ealfaro29/livinginacat-world/public/assets/social-cat-world-dark-v2.png

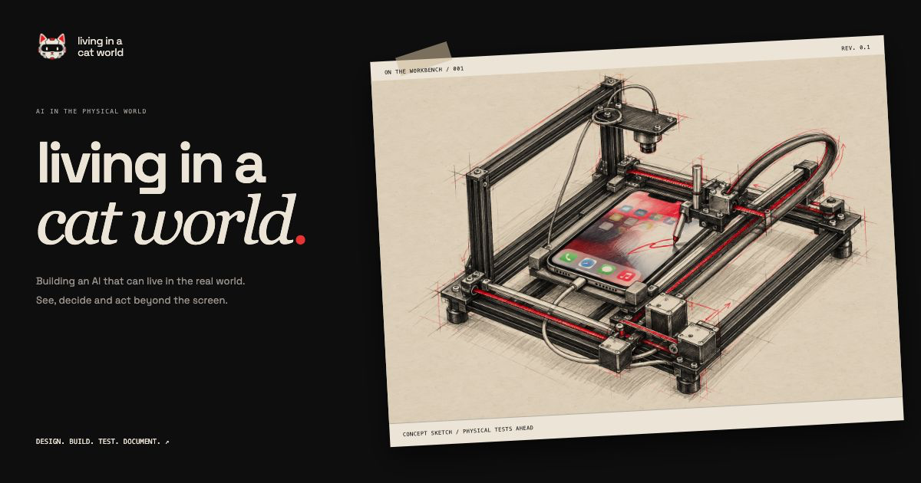
public/assets/social-cat-world-dark-v2.png
