ealfaro29/livinginacat-world/public/assets/prototype-rough-v1.png

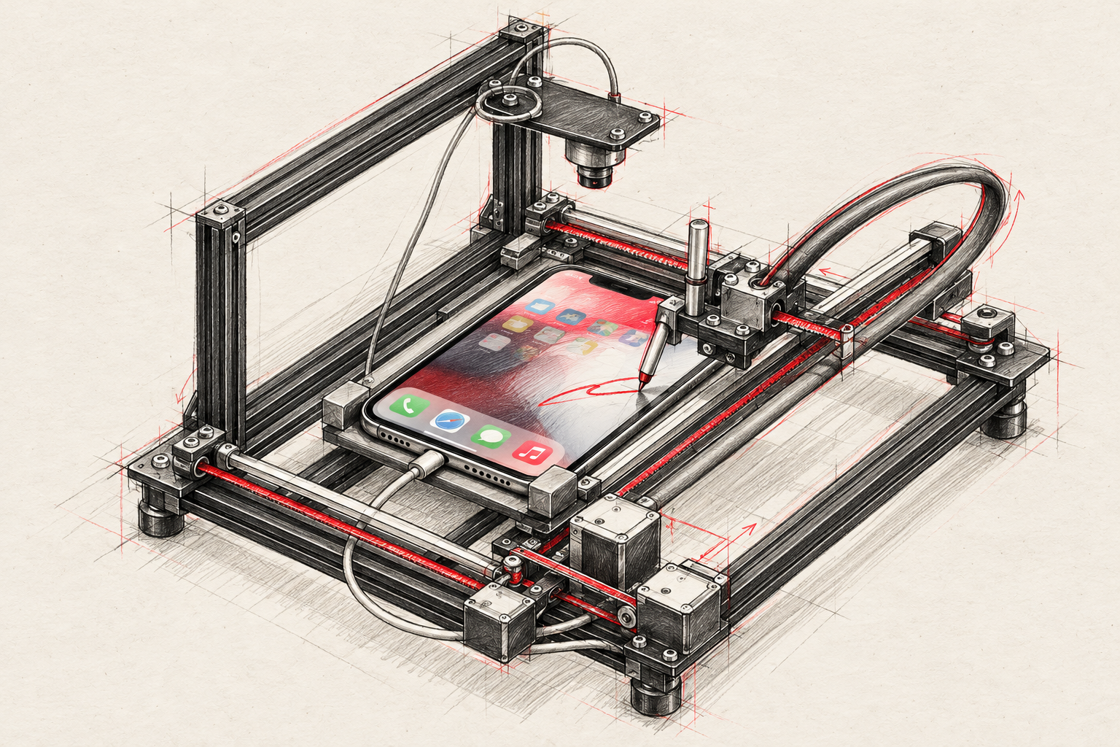
public/assets/prototype-rough-v1.png
