ealfaro29/livinginacat-world/hardware/ft412/PUBLIC-RELEASE.md

# Public release scope

16 final STL designs and their 16 STEP files; 22 installed printed parts plus three fit coupons. The v0.1 archive remains the original digital-review snapshot, with its checksum unchanged. Use `qa/print-manifest.json` for quantities and `README.md` for planned assembly.

Current build observations, reported November 13, 2026: the first test batch is complete and the owner reports M3 and M5 checks passed in PLA Silk with a 0.4 mm nozzle. M4, coupler fit, PETG and full assembly acceptance remain unvalidated. Results for each hole, pocket and head seat were not individually itemized. These observations do not certify the archive or change its geometry. See the [dated fit-check report](/documentation/fit-checks/).

This release excludes commercial `vendor/`, `reference_step/`, `original_stl/`, `upstream/`, reference assemblies and regeneration scripts that depend on them. Intermediate CAD records may describe the larger private working environment; they are not additional printable parts or a self-contained regeneration pipeline.

Public instructions are in English. Machine-generated CAD review artifacts retain their original identifiers and some original-language annotations. They are evidence snapshots, not proof of physical performance.

The provisional development temperature stop is unified to 45 °C on externally measured body/support surfaces, alongside the guide’s timing limits. This unvalidated rule does not measure internal coil temperature.
