ealfaro29/livinginacat-world/docs/DATA.md

# Ledger maintenance

Public source: `data/ledger.json`. USD amounts are integer cents. `null` means unknown. Dates use YYYY-MM-DD. `updatedAt` retains the UTC review date; `reviewedAt` is the completed source-review timestamp and `reviewTimeZone` controls its display in Costa Rica. Neither is a delivery event. A shipment's `speedyReviewedAt` records the latest full-account check without replacing its carrier or recipient event date. Confirmed carrier deliveries display `carrierDeliveredDate`, or explicitly leave the date unknown, rather than reusing an earlier estimate.

`data/build-progress.json` contains selected, anonymized current build observations, separate from the immutable v0.1 CAD archive metadata. The November 13 owner report confirms M3 and M5 checks in PLA Silk, without itemized hole, pocket or seat measurements. Keep M4, coupler fit, PETG and full assembly acceptance unconfirmed. These coupon observations do not validate the complete robot or change the archive's checksum.

## Overlapping records: do not add together

- `items`: original equipment list and quotes. Quantity means purchase units, not always individual parts. Quoted total = quantity × quoted unit price.
- An unquoted local purchase keeps both quote amounts `null`; downloads leave numeric price cells blank. The known equipment estimate excludes it and states how many lines remain unquoted. Stable item IDs survive a replacement or vendor change; `previousProcurement` retains the earlier quote. A cancelled vendor's quote remains historical even after the current items move to another vendor.
- `equipmentAllowances`: owner-requested planning amounts, kept separate from item quotes, orders and verified payments. The equipment estimate is item quotes plus these allowances.
- `orders`: vendor-level quote, documentary order total and verified payment where evidence exists. `invoiceTotalCents` is the order amount; `shippingInvoicedCents`, `taxInvoicedCents` and `tariffInvoicedCents` describe its charges. An order confirmation alone does not establish payment. The owner may confirm shipped purchases are paid; record this as owner confirmation rather than bank verification. `actualPaidCents` and the `*PaidCents` fields remain unknown when a reliable amount is unavailable. For a partially shipped order, do not assume the whole order is paid or invent an allocation. For a vendor aggregate, `paymentPartial` marks a subtotal across confirmed paid orders. Paid tax and shipping are breakdowns of the paid total, not additional amounts to add again.
- An `awaiting_invoice` order acknowledges a request awaiting the vendor's final invoice. `invoiceTotalFinal: false` and `shippingChargeFinal: false` distinguish provisional amounts from final charges; neither establishes payment or dispatch.
- `amazonOrders`: anonymized extracts of confirmed orders. They include equipment and extras. Documentary order totals are distinct from reconciled bank payments. When complete carrier fulfillment is verified, the owner's existing confirmation that shipped purchases are paid can cover the documented total; retain the owner-confirmation source and the bank-settlement caveat.
- `otherExpenses`: domain and grouped **Taxes, tariffs, shipping and others** totals per vendor. `includedInVendorOrderTotals: true` prevents double counting. The grouped total includes documented vendor shipping, taxes, tariffs and other included costs. Keep the underlying actual tax and tariff evidence in the private records; do not describe other purchases as tax. Speedy charges in CRC are separate. A standalone owner-confirmed project expense uses the same grouped label with `includedInVendorOrderTotals: false`; its verified payment is added once to project totals. It creates no equipment, vendor order or shipment record when the owner confirms there is no shipping.
- `forwardingCharges`: one dated combined Speedy amount in CRC for **all current packages**, with no filter by project membership. Review the entire current account and all current consolidations, including packages not yet quoted. Review active `Recibido`, `En Costa Rica` and `Enviado` queues without filtering charges by a known consolidation, project match or earlier review. `Enviado` alone does not prove payment. Exclude records confirmed `Pagado` or `Entregado` unless newer evidence establishes an outstanding charge. When a new consolidated parcel coexists with its original records and their billing replacement relationship is not verified, use `hasUnresolvedConsolidationCharges` in `aggregateForwardingCharges`. It returns `amountCRC: null` and `quoteStatus: reconciliation_pending`; publish the pending status without a numeric total. Preserve the last verified amount privately and in dated history. Do not infer charge replacement from similar weights, dates or counters. Use `aggregateForwardingCharges` to sum every quoted current package once; unquoted packages keep `quoteStatus: awaiting_remaining_quotes` and must never be treated as free or omitted from the review. Publish only the combined amount, currency, observation date, coverage and payment/finality caveats. Package identities, counts, weights, individual charges, matching evidence and the complete observation history stay outside user-facing views. The owner explicitly requires this full scope. Do not add restricted package details to project records or location counts. Do not mark the amount paid or combine it with USD totals without evidence, and do not assume it is the final consolidated balance.
- `shipments`: real project shipment or preparation record. `trackingAssigned` records that the private project shipment has a verified assigned number; the number itself stays private. It does not establish carrier acceptance, Speedy receipt or recipient delivery. `status` describes the carrier; `speedyStatus` describes separately confirmed forwarder progress. `speedyLocation` is `miami` or `costa_rica` only when Speedy's exact tracking entry supports it; otherwise it is `null`. `speedyCheckedAt` records the review date, and `speedyConfirmedAt` records the latest affirmative observation. Planned dispatch is distinct from estimated arrival. Complete `deliveredAt` only with recipient-delivery evidence. A suffix-only tracking match is insufficient for a project location assertion.
- `funding`: preserve unknown amounts until reconciled. Do not publish individual supporters or contributions without authorization.

Carrier-verified tracking aliases may establish project identity when Speedy scans a longer carrier barcode. Keep both exact references and the independent carrier evidence privately. Matching a suffix alone is insufficient. The two original Amazon FedEx shipments are confirmed in Costa Rica after their vendor tracking and Speedy barcode independently resolve to identical FedEx shipment facts; recipient delivery remains unconfirmed.

The November 9 full-account identity audit also verifies the longer USPS barcodes for BoltDepot, PhotonLight, West3D and Walmart spacers: both complete identifiers independently resolve to identical full USPS tracking histories, and Speedy shows each as `Recibido`. Record these shipments as `received` in Miami, ready for forwarding to Costa Rica. `Recibido` is affirmative Speedy receipt; it must not remain described as unconfirmed after this identity verification. Keep each Walmart fulfillment group tied to its own item and shipment so a spacer receipt does not advance the foam or wrap. Preserve these verified aliases for subsequent reviews and the owner's item marks separately.

Cancelled orders retain their original documentary amounts and grouped charges, with unknown payments and refunds unchanged. Exclude them from active order totals, active grouped-cost summaries and the tracking queue. Cancellation does not itself establish a refund. Confirmed replacements get their own order and preparation record; a planned local purchase gets no imported shipment or Speedy prealert.

Keep cancelled shipment records in `shipments` as history. `activeShipments` excludes them, and shipments whose parent order is cancelled, from public tracking groups, coverage and location counts. A vendor-reported refund may have `refundCents` while `refundStatus: vendor_reported` and `refundBankSettlementConfirmed: false` preserve the distinction from a verified bank credit.

Owner-confirmed payment and recipient delivery exclude historical forwarding charges even when Speedy retains an old `Enviado` label. Pass explicitly settled references through `aggregateForwardingCharges`'s `settledTrackings` option; preserve those references and the confirmation privately. Do not exclude an unsettled charge merely because it is old or marked `Enviado`. Only new evidence of an outstanding balance can reopen a confirmed settlement.

## Initial evidence

Carrier returns use `shipments.status: returned` and remain separate from recipient delivery, refunds and replacements. Keep the original purchase and payment evidence. A return still counts as a reported shipment; it appears in the carrier-return group instead of the queue awaiting Speedy confirmation. The private carrier record uses `on_hold` with the verified return evidence.

Bambu Lab support confirmed the original return and offered a replacement at no additional vendor charge. Preserve the original purchase, payment, returned shipment and all documents. USPS confirmed acceptance on November 12 and out for delivery on November 13, then actual carrier delivery to the Miami destination on November 13 at 4:50 PM, in or at the mailbox; the source timezone is unspecified. This carrier event does not establish Speedy receipt, Costa Rica arrival or recipient delivery. The unique original prealert remains complete and is now verified in a newly created forwarding group without recreation or early shipment. That group has no receipts linked. Its operational identifiers, membership and documents remain protected. No refund or bank settlement is independently confirmed.

FramingTech: payment email and PDF confirmation. GoDaddy: email receipt. Amazon: authenticated order details, order invoices and tracking pages. DigiKey and BoltDepot: vendor order confirmation emails, without shipment or settled-payment evidence. Walmart: confirmation email and authenticated order details; fulfillment groups at Placed status and estimated arrival windows are not dispatched packages. Private originals stay outside the repository. AMZ codes are public references independent of actual order numbers.

Mouser: the November 5 owner confirmation and original order-summary PDF total $82.07 and remain historical `order_confirmation` evidence. On November 7 the authenticated order page and shipping email confirm all ten references shipped with FedEx tracking. The authentic final invoice verifies one unit of each reference, a $87.22 total and an explicit paid-in-full vendor statement. Record that vendor payment evidence separately from unverified bank settlement; retain the previous confirmation amount. Invoice goods values support the prealert article entries; do not turn vendor charges into additional goods. Only the combined vendor charges are published under Taxes, tariffs, shipping and others. FedEx confirms carrier delivery in Miami on November 9. Its authentic final invoice, Speedy prealert and consolidation remain confirmed. Record the November 9 carrier delivery separately. On November 10 Speedy confirms received in Miami after both full FedEx identifiers independently resolve to identical complete travel history and shipment facts. Keep the verified barcode alias privately. Costa Rica arrival and recipient delivery remain unconfirmed; preserve the original invoice, prealert, consolidation assignment and purchase amount. The planned local wire purchase remains unconfirmed.

VXB: the owner sent the cancellation request on November 5. The vendor confirmed cancellation on November 6 and reports a full $65.22 refund; receipt by the bank is not independently verified. Retain the original order amounts, USPS label, Speedy prealert and consolidation as history, excluded from active order totals and shipment counts. The earlier expected restock date is superseded by cancellation.

Amazon controller replacement: authenticated order details and the original printable confirmation verify the November 7 purchase. AMZ-07 remains a separate order, and the stable controller item retains the cancelled VXB quote in `previousProcurement`. The November 9 complete fulfillment review identifies the controller's own Amazon tracking, Shipped at step 2 of 4, with estimated Miami arrival November 10. Its earlier parcel association is corrected using the actual item in each fulfillment group. The current authenticated purchase PDF and matching merchant transaction marked Completed support a genuine purchase receipt; this does not verify bank settlement or a final tax invoice. The original confirmation is preserved. Speedy now confirms the controller prealert and its consolidation together with the Mouser shipment. Carrier delivery and Speedy receipt remain unconfirmed. Keep the shared receipt in protected operational evidence outside the ordinary owner room, retain only the combined public order total, and include charges once under Taxes, tariffs, shipping and others. `costVisibility: vendor_grouped` keeps private components distinct from unknown or zero amounts. Track other operational parcels separately; never assign an item to the first tracking link merely because it belongs to the same order. Submit one prealert per exact tracking with only that parcel's authentic goods quantities and values. On November 10 the exact controller tracking page confirms Delivered today at the verified Miami destination. Record carrier_delivered and the November 10 carrier event separately from unconfirmed Speedy receipt and recipient delivery; keep the original purchase and payment evidence unchanged.

Walmart: the authenticated exact-order page showed every fulfillment group delivered on the November 6 review. The arrival email and matching wrap group confirm its carrier delivery on November 6, tied to the existing tracking through the earlier shipment evidence. Complete order fulfillment also confirms the foam's carrier delivery; do not assign an individual delivery date that has not been matched. Payment amounts remain unchanged. Carrier delivery does not establish Speedy receipt or delivery to the recipient. On November 10 Speedy confirms the cable-management shipment received in Miami. Both complete USPS identifiers independently show identical full histories, including carrier delivery to an agent on November 6 at 10:08 AM. Preserve the verified alias privately and keep the foam group separate and unresolved. Costa Rica arrival and recipient delivery for the cable-management shipment remain unconfirmed.

## Updating

In the November 14 UTC review (November 13 in Costa Rica), Speedy confirms the exact Walmart cable-management shipment in Costa Rica through its previously independently verified full USPS alias. The same exact scanned reference is now listed among receipts in its original consolidation. Actual arrival date and recipient delivery remain unconfirmed. Preserve the original carrier delivery, purchase, prealert and assignment. USPS separately confirms carrier delivery of the replacement to Miami on November 13; do not mark Miami in the item tracker until Speedy confirms receipt.

On November 13 Speedy confirms the existing BoltDepot, Walmart spacers and PhotonLight shipments in Costa Rica. Each current entry matches its previously verified complete carrier alias, and the same three packages are now explicitly linked among the received packages of their existing consolidation. Preserve each original purchase, carrier delivery, PDF, prealert and assignment. This advances only the three exact project shipments; recipient delivery and the actual arrival dates remain unconfirmed. The replacement's separate USPS out-for-delivery status does not establish Speedy receipt. Forwarding-charge reconciliation remains pending without a numeric aggregate.

Owner-reported recipient delivery plans are dated forecasts. Record the date of the owner report separately from the expected recipient delivery date. Preserve item stages and leave recipient receipt unconfirmed until the owner or an exact forwarding record confirms it; a processed consolidation or planned date creates no tracking alias and resolves no billing relationship.

On November 12 the owner confirms receipt of existing project shipments, corroborated by their exact Speedy entries now marked delivered. Advance only the precisely matched project shipments and item groups, preserving split-order associations and owner checkbox edits. The earlier recipient delivery forecast is superseded. Keep the actual delivery date unknown and distinguish receipt of a shipment from verification of every piece and quantity inside it. The owner also confirms the physical count and relative size groups of the FramingTech profiles; their exact cut lengths remain unmeasured. Forwarding billing reconciliation remains pending, without a current numeric total or an inferred container alias.

On November 11 the owner identified the previously unresolved Walmart foam package and confirmed physical receipt. The protected original tracking and alternate forwarder code are linked by explicit owner confirmation, separately from carrier-verified aliases. Record the project foam as delivered to the recipient, preserve the existing carrier delivery, purchase, prealert and consolidation, and keep the exact recipient delivery date unknown. The former unresolved tracker row is retained as protected history and linked to the existing foam item rather than displayed twice. This does not advance the separate cable-management or spacer shipments.

On November 11 three project prealerts for shipments already received in Miami were reassigned to the current active forwarding consolidation with owner authorization. Their authentic documents, quantities and declared values were preserved and the three destination entries were verified without duplicates. Keep exact consolidation membership and administrative form dates in protected evidence and the authenticated tracker. Recreating a prealert does not establish an arrival, advance a shipping phase or change the purchase total or observed forwarding charges.

On November 11 Speedy confirms receipt in Miami for the exact project controller tracking. Preserve Amazon's separate November 10 carrier delivery, the authentic purchase receipt, prealert and current consolidation. The observation date is not a verified Speedy receipt event date. Costa Rica arrival, recipient delivery, bank settlement and final tax invoice remain unconfirmed.

1. Read current evidence and retain its original reference privately.
2. Update only verified fields, preserving uncertainty.
3. Add a `changes` entry with date, title and detail. Record verified cancellation, refund or return amounts explicitly; retain history rather than silently deleting records.
4. Run arithmetic and relationship tests. Expand checks when the data model changes.
5. Regenerate and compare CSV, JSON, Markdown and HTML against the same source.
6. Commit, publish and verify live. Journal posts remain dated snapshots; tables show the latest record.

Maintaining this ledger does not authorize purchases, payment-method changes, outgoing email or recurring monitoring.

## Public and private boundary

Never mention or display personal purchase details in messages, the public site, downloads or the interactive owner room. Preserve operational evidence outside those views; shared-order originals are not downloadable through the owner room. Public records retain their exact grouped amounts under Taxes, tariffs, shipping and others without product names, product identifiers, quantities, photos, invoices or descriptions that reveal those purchases. Preserve actual tax and tariff amounts; do not relabel other purchases as tax. Shipment updates for this category use a generic title. Never copy private admin data or original invoice contents into public source, posts, downloads, screenshots or commit messages. `npm run check` blocks restricted identities before publication.

TechStorex: the owner confirms an additional project expense of $537.00, temporarily classified under Taxes, tariffs, shipping and others. Original payment evidence is retained privately. It has no shipping, equipment allocation, tracking or Speedy prealert. Bank settlement is not independently verified. The vendor total is recorded once as a standalone expense.
