ealfaro29/livinginacat-world/public/assets/brand/robot-cat-180.png

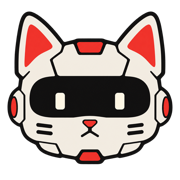
public/assets/brand/robot-cat-180.png
