ealfaro29/livinginacat-world/hardware/ft412/qa/parts-preview.png

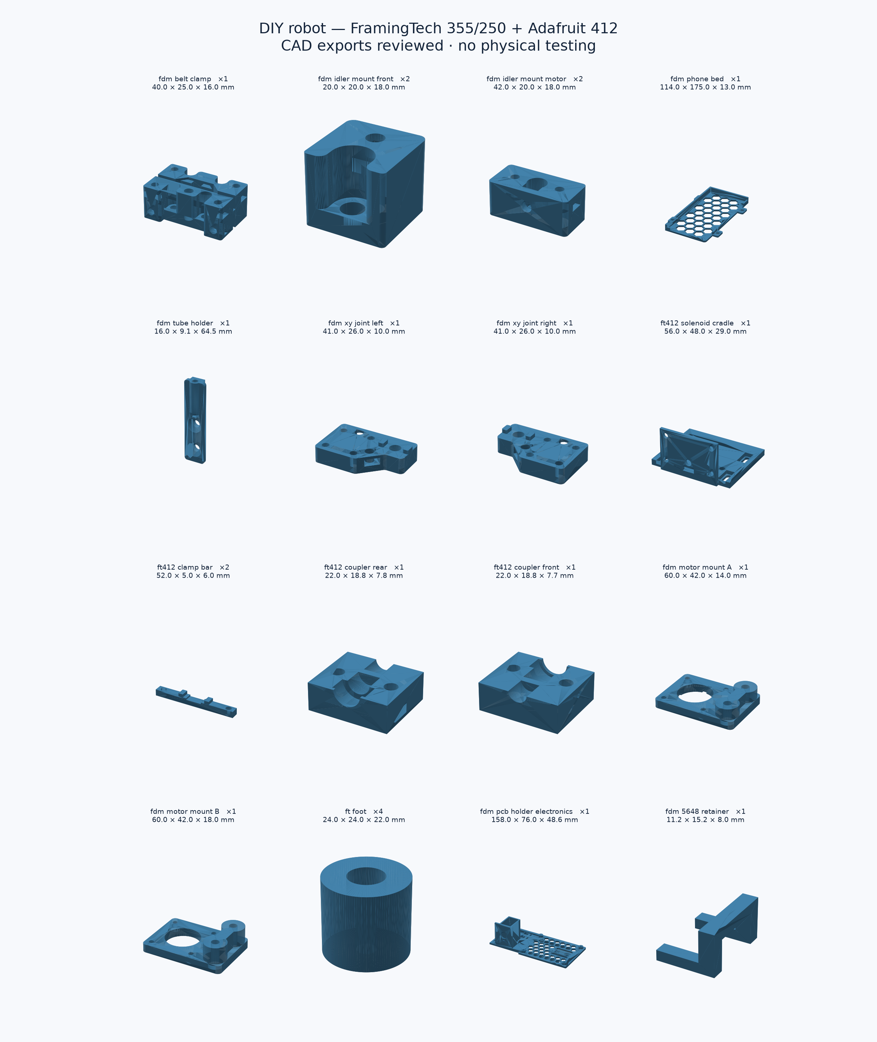
hardware/ft412/qa/parts-preview.png
