ealfaro29/livinginacat-world/public/assets/shopping-list-1080x1440.png

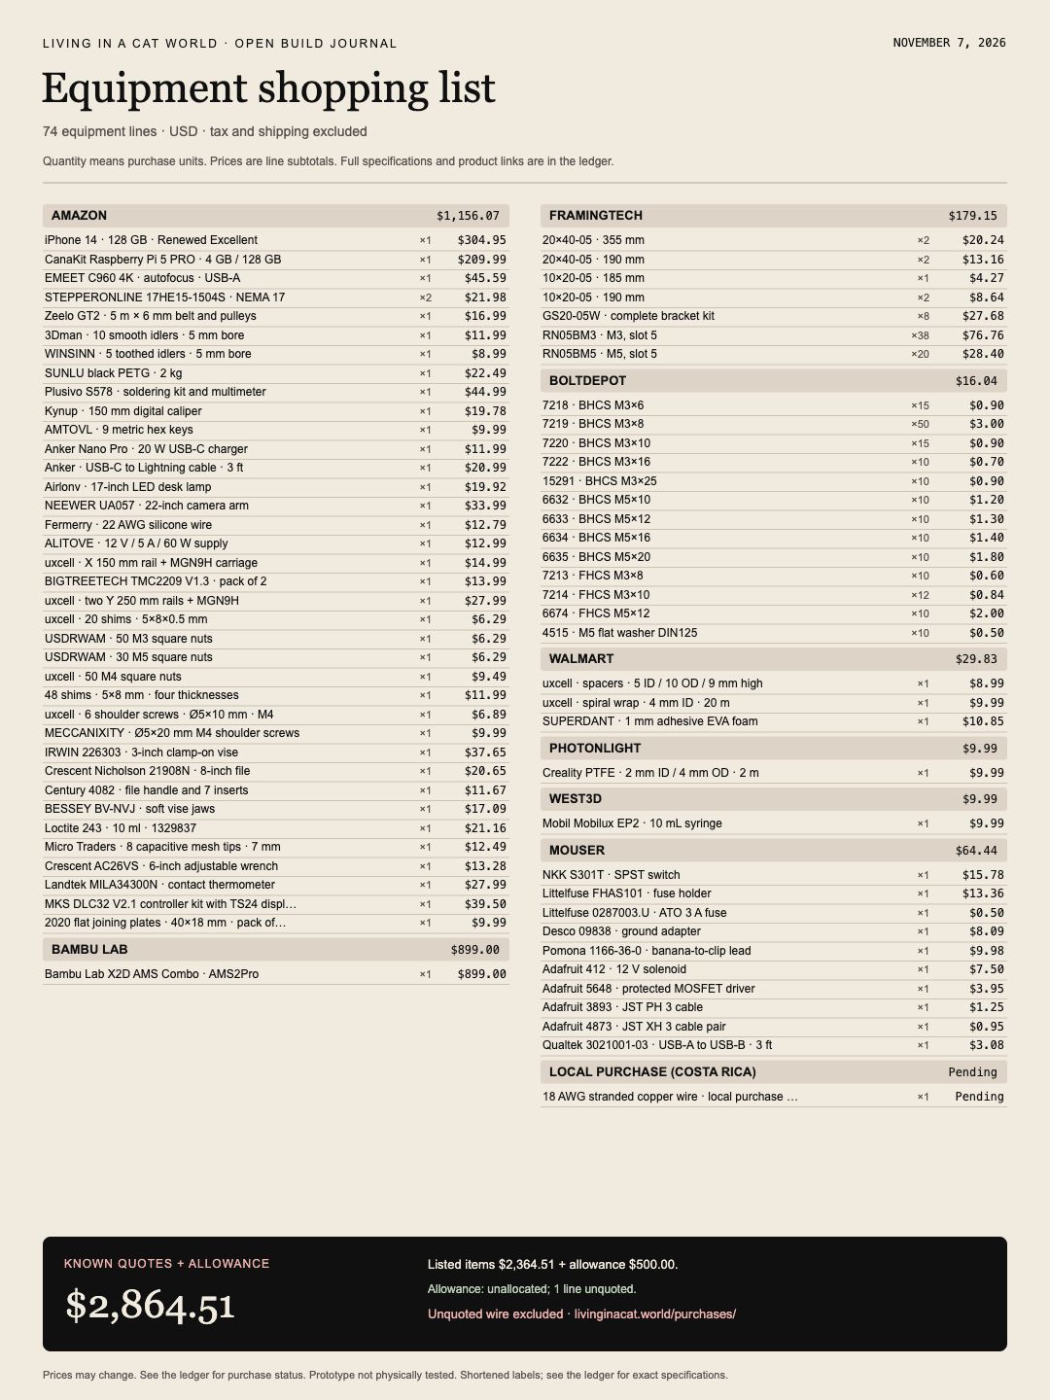
public/assets/shopping-list-1080x1440.png
