ealfaro29/livinginacat-world/hardware/ft412/coupons/fdm_countersink_coupon.stl

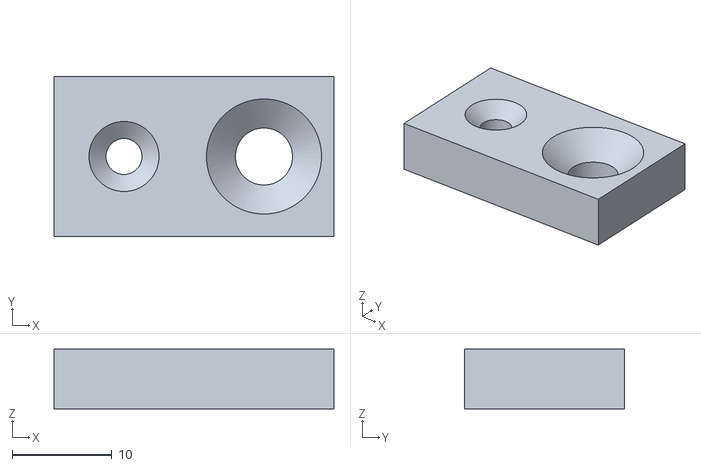
[picture p6: CAD file, 2026-10-26]
hardware/ft412/coupons/fdm_countersink_coupon.stl
28.0 x 16.0 x 6.00
