ealfaro29/livinginacat-world/hardware/ft412/step/ft412_coupler_rear.step

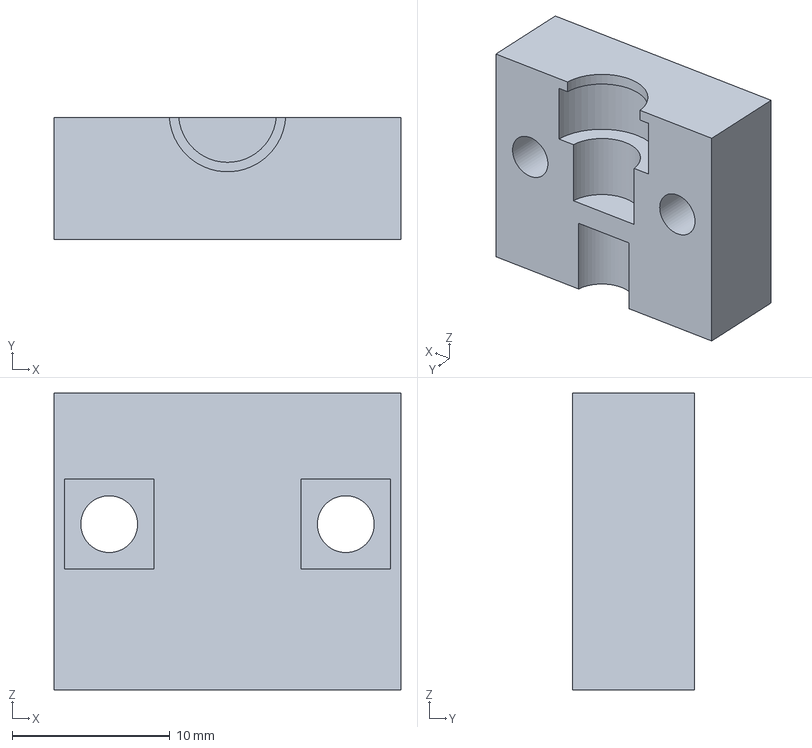
[picture p7: CAD file, 2026-10-26]
hardware/ft412/step/ft412_coupler_rear.step
22.0 x 7.75 x 18.8 mm
