ealfaro29/livinginacat-world/hardware/ft412/step/fdm_motor_mount_A_x1.step

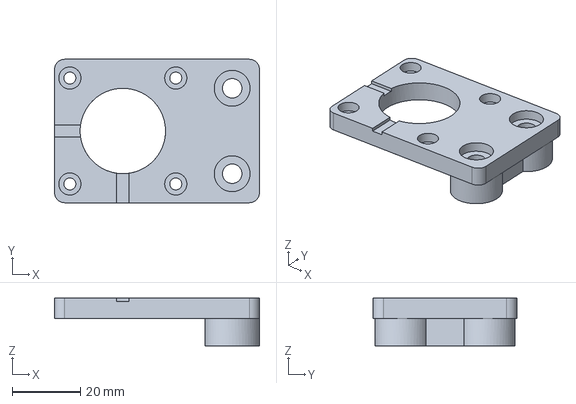
[picture p8: CAD file, 2026-10-26]
hardware/ft412/step/fdm_motor_mount_A_x1.step
60.0 x 42.0 x 14.0 mm
