ealfaro29/livinginacat-world/hardware/ft412/coupons/fdm_clearance_coupon.stl

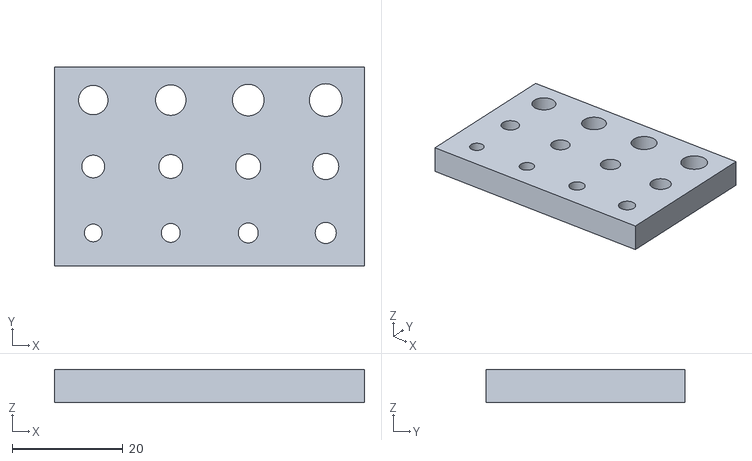
[picture p9: CAD file, 2026-10-26]
hardware/ft412/coupons/fdm_clearance_coupon.stl
56.0 x 36.0 x 6.00
