ealfaro29/livinginacat-world/hardware/ft412/step/fdm_belt_clamp_x1.step

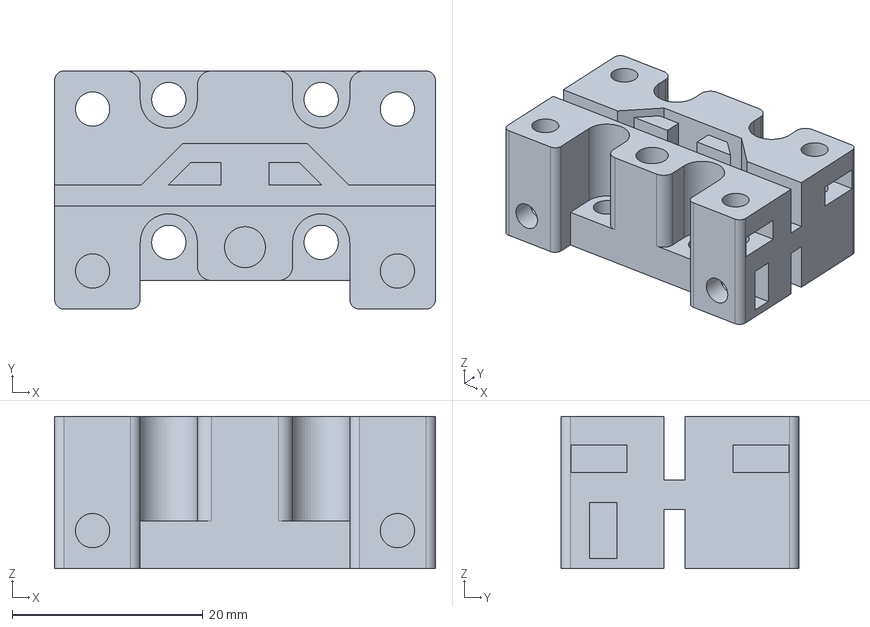
[picture p10: CAD file, 2026-10-26]
hardware/ft412/step/fdm_belt_clamp_x1.step
40.0 x 25.0 x 16.0 mm
