ealfaro29/livinginacat-world/hardware/ft412/step/fdm_pcb_holder_electronics_x1.step

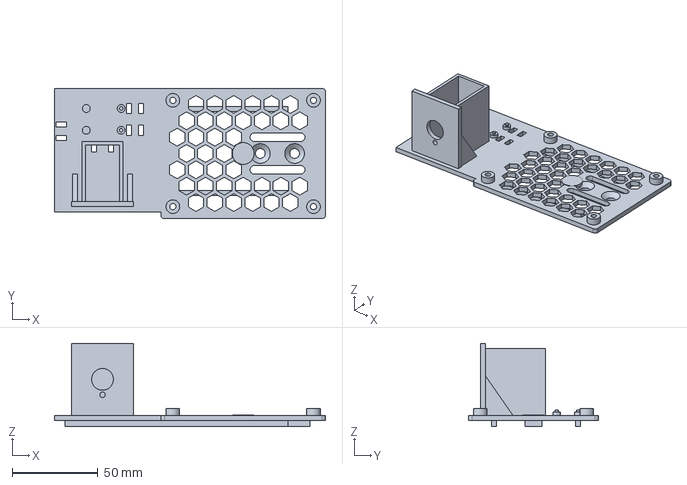
[picture p11: CAD file, 2026-10-26]
hardware/ft412/step/fdm_pcb_holder_electronics_x1.step
158.0 x 76.0 x 48.6 mm
