ealfaro29/livinginacat-world/hardware/ft412/step/fdm_xy_joint_left_x1.step

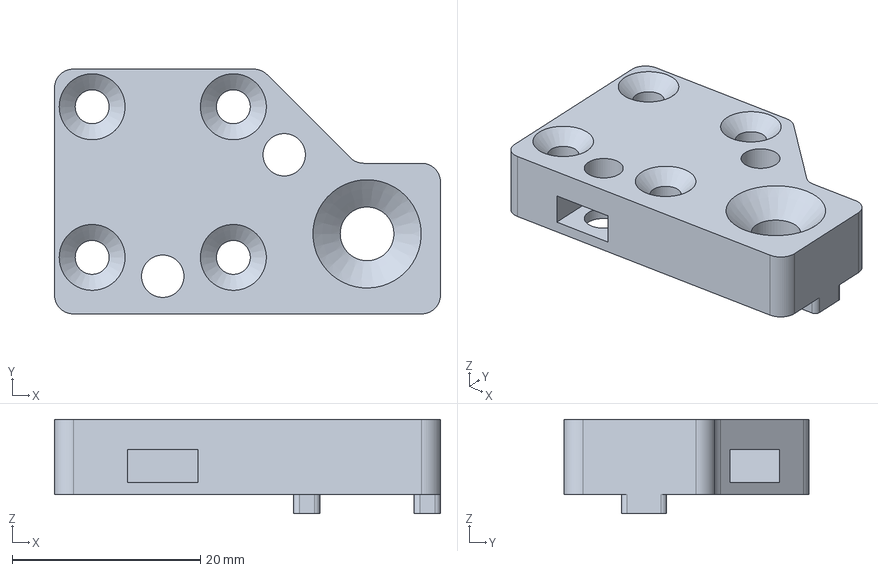
[picture p12: CAD file, 2026-10-26]
hardware/ft412/step/fdm_xy_joint_left_x1.step
41.0 x 26.0 x 10.0 mm
