ealfaro29/livinginacat-world/hardware/ft412/step/fdm_idler_mount_front_x2.step

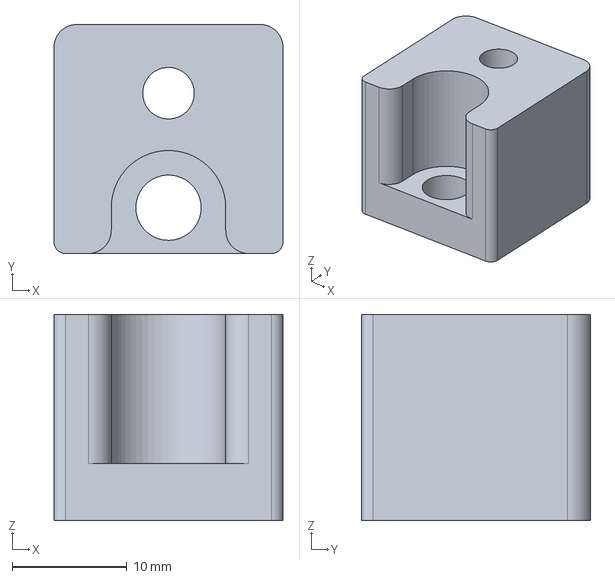
[picture p13: CAD file, 2026-10-26]
hardware/ft412/step/fdm_idler_mount_front_x2.step
20.0 x 20.0 x 18.0 mm
