ealfaro29/livinginacat-world/hardware/ft412/step/ft412_clamp_bar_x2.step

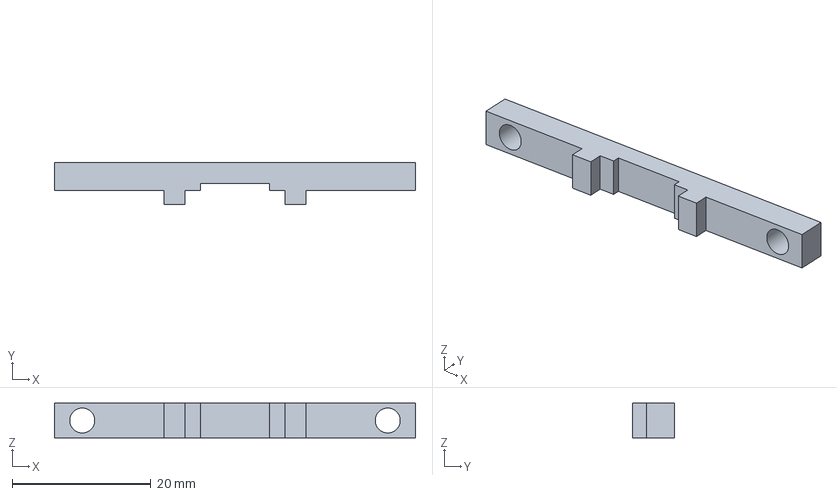
[picture p14: CAD file, 2026-10-26]
hardware/ft412/step/ft412_clamp_bar_x2.step
52.0 x 6.00 x 5.00 mm
