ealfaro29/livinginacat-world/hardware/ft412/step/ft_foot_x4.step

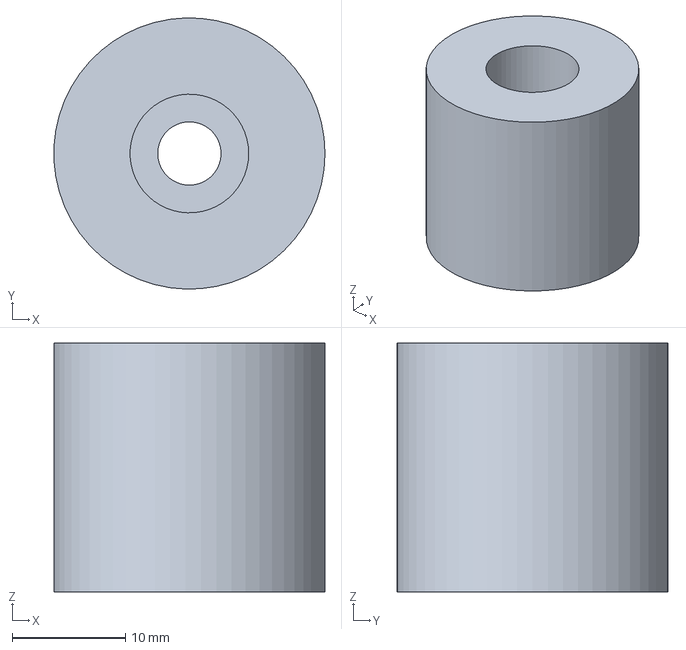
[picture p15: CAD file, 2026-10-26]
hardware/ft412/step/ft_foot_x4.step
24.0 x 24.0 x 22.0 mm
