ealfaro29/livinginacat-world/hardware/ft412/step/fdm_idler_mount_motor_x2.step

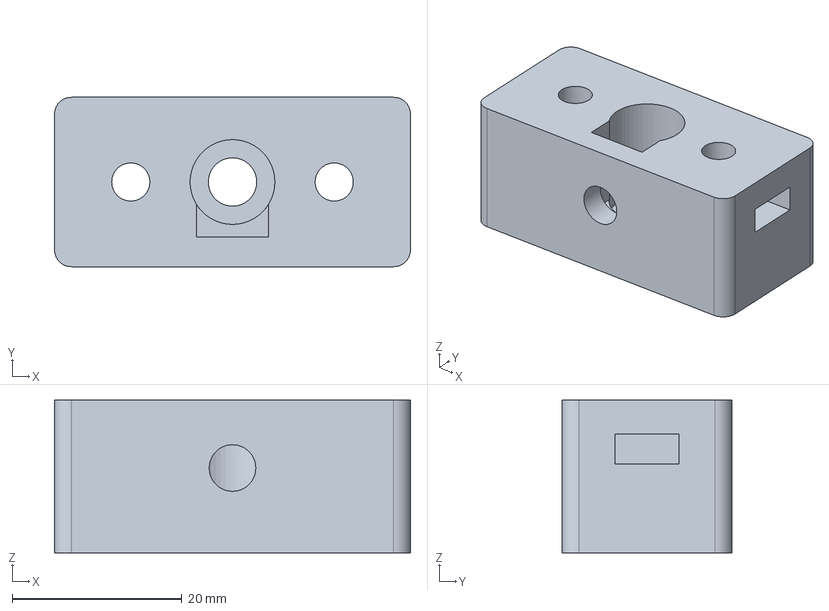
[picture p16: CAD file, 2026-10-26]
hardware/ft412/step/fdm_idler_mount_motor_x2.step
42.0 x 20.0 x 18.0 mm
