ealfaro29/livinginacat-world/hardware/ft412/step/fdm_5648_retainer_x1.step

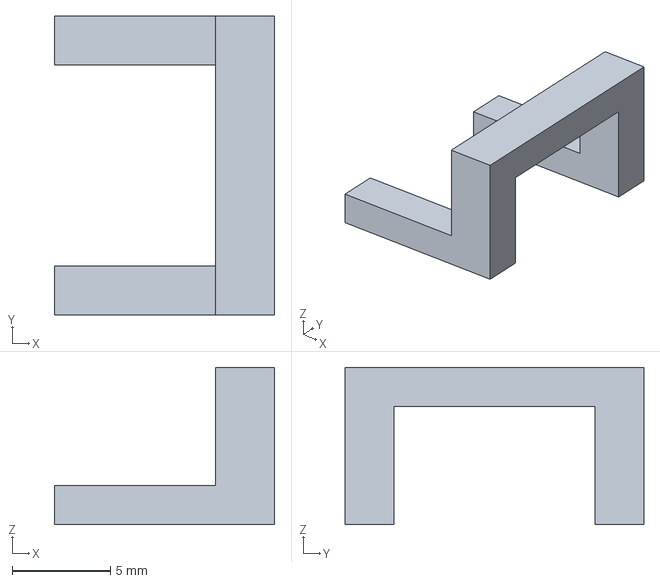
[picture p18: CAD file, 2026-10-26]
hardware/ft412/step/fdm_5648_retainer_x1.step
11.2 x 15.2 x 8.00 mm
