ealfaro29/livinginacat-world/hardware/ft412/step/ft412_solenoid_cradle.step

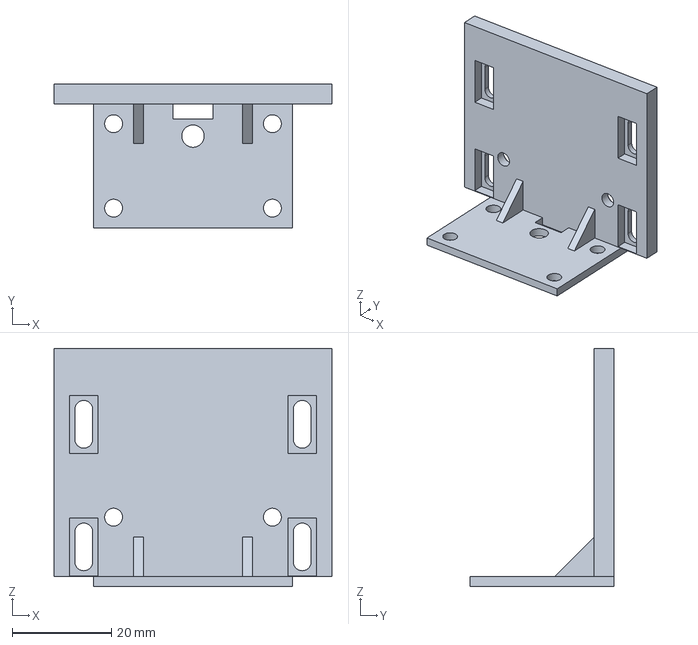
[picture p19: CAD file, 2026-10-26]
hardware/ft412/step/ft412_solenoid_cradle.step
56.0 x 29.0 x 48.0 mm
