ealfaro29/livinginacat-world/hardware/ft412/step/fdm_tube_holder_x1.step

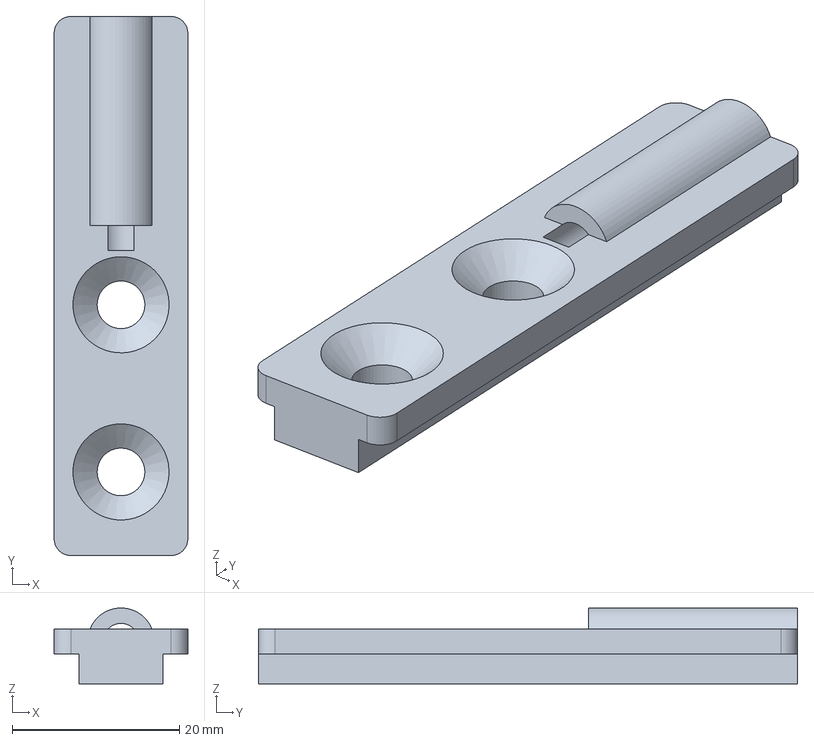
[picture p20: CAD file, 2026-10-26]
hardware/ft412/step/fdm_tube_holder_x1.step
16.0 x 64.5 x 9.09 mm
