ealfaro29/livinginacat-world/hardware/ft412/step/ft412_coupler_front.step

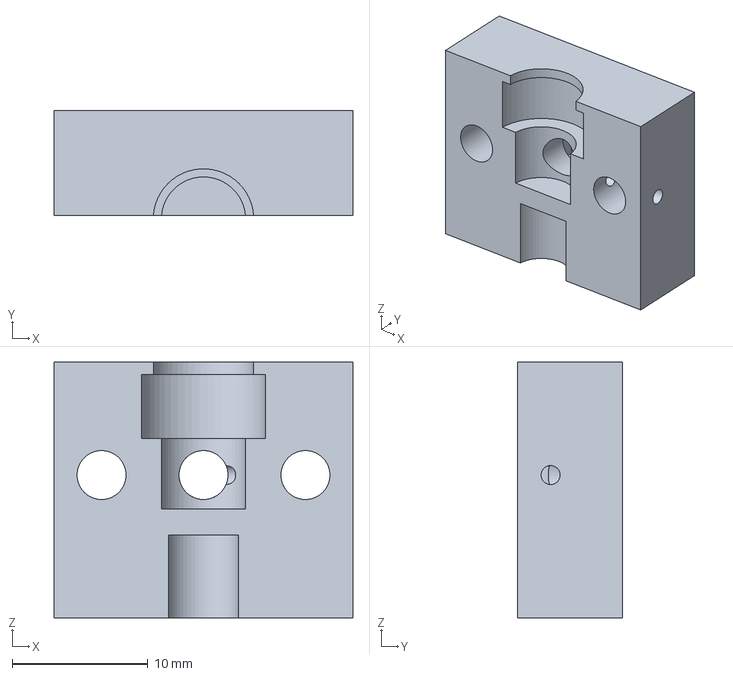
[picture p21: CAD file, 2026-10-26]
hardware/ft412/step/ft412_coupler_front.step
22.0 x 7.75 x 18.8 mm
