ealfaro29/livinginacat-world/hardware/ft412/step/fdm_phone_bed_x1.step

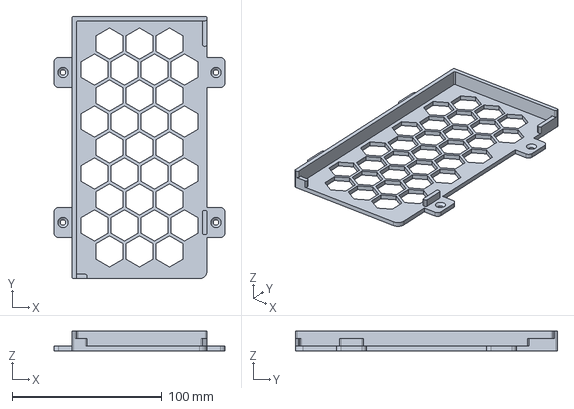
[picture p22: CAD file, 2026-10-26]
hardware/ft412/step/fdm_phone_bed_x1.step
114.0 x 175.0 x 13.0 mm
