ealfaro29/livinginacat-world/(list of files, cad)

Other CAD files:
hardware/ft412/step/fdm_xy_joint_right_x1.step
hardware/ft412/coupons/fdm_square_nut_coupon.stl
hardware/ft412/stl/fdm_5648_retainer_x1.stl
hardware/ft412/stl/fdm_belt_clamp_x1.stl
hardware/ft412/stl/fdm_idler_mount_front_x2.stl
hardware/ft412/stl/fdm_idler_mount_motor_x2.stl
hardware/ft412/stl/fdm_motor_mount_A_x1.stl
hardware/ft412/stl/fdm_motor_mount_B_x1.stl
hardware/ft412/stl/fdm_pcb_holder_electronics_x1.stl
hardware/ft412/stl/fdm_phone_bed_x1.stl
hardware/ft412/stl/fdm_tube_holder_x1.stl
hardware/ft412/stl/fdm_xy_joint_left_x1.stl
hardware/ft412/stl/fdm_xy_joint_right_x1.stl
hardware/ft412/stl/ft412_clamp_bar_x2.stl
hardware/ft412/stl/ft412_coupler_front.stl
hardware/ft412/stl/ft412_coupler_rear.stl
hardware/ft412/stl/ft412_solenoid_cradle.stl
hardware/ft412/stl/ft_foot_x4.stl
