ealfaro29/livinginacat-world/(commit log)

2026-10-26 Launch English open build journal with purchase and shipment ledger
    [fdm_5648_retainer_x1.step, fdm_5648_retainer_x1.stl, fdm_belt_clamp_x1.step, fdm_belt_clamp_x1.stl, fdm_clearance_coupon.stl, fdm_countersink_coupon.stl, fdm_idler_mount_front_x2.step, fdm_idler_mount_front_x2.stl]
2026-10-26 Publish English CAD preview with reproducible rendering source
2026-10-26 Version public assets so browsers receive the current design
2026-10-26 Frame the journal around building an AI for the real world
2026-10-26 Record confirmed DigiKey order and its final charges
2026-10-26 Record BoltDepot order and additional owner-selected spares
2026-10-27 Update purchase ledger and publish project progress
2026-10-27 Track carrier and Speedy package statuses separately
2026-10-28 Replace withdrawn plate quote with purchased Amazon plates
2026-10-28 Record shipped joining plates and prealert
2026-10-28 Record Walmart spacer shipment and prealert
2026-10-28 Update frame shipment and forwarder receipts
2026-10-28 Record carrier delivery of frame plates
2026-10-29 Track observed forwarding charges separately
2026-10-29 Record forwarder receipt and displayed charge
2026-10-30 Record confirmed shipment and forwarding charge
2026-10-30 Record shipment receipt and forwarding charge
2026-11-03 Add local iPhone vision prototype
2026-11-03 Simplify camera view and add webcam focus
2026-11-03 Persist screen calibration and reduce camera reflections
2026-11-03 Restore visible manual screen calibration controls
2026-11-03 Add camera controls and simulated element targeting
2026-11-03 Update verified Speedy status and forwarding charge
2026-11-03 Include all current packages in the Speedy aggregate
2026-11-03 Update current forwarding aggregate and confirmed project receipt
2026-11-04 Refresh combined current forwarding amount
2026-11-04 Update combined current forwarding quote
2026-11-05 Record Mouser replacement purchase and planned local wire
2026-11-05 Record vendor restock delay and provisional order charges
2026-11-06 Document planned Amazon controller replacement and current review
2026-11-06 Exclude owner-confirmed settled forwarding charges from current total
2026-11-06 Clarify current vendor resolution in the order summary
2026-11-06 Refresh combined current forwarding amount and clarify prior observations
2026-11-06 Reconcile vendor cancellation, carrier deliveries and current forwarding progress
2026-11-07 Record Mouser dispatch and current forwarding total
2026-11-14 Confirm replacement carrier delivery and cable shipment arrival
2026-11-14 Sync current project status and initial fit checks
